muditbhargava66/open-crypto-hdl/src/aes_gcm_top.v

// ============================================================
//  aes_gcm_top.v — AES-256-GCM Logic Wrapper
//  NIST SP 800-38D
// ============================================================
/* verilator lint_off MULTITOP */
`default_nettype none
module aes_gcm_top (
    input  wire         clk,
    input  wire         rst_n,

    // Configuration
    /* verilator lint_off UNUSED */
    input  wire [255:0] key,
    /* verilator lint_on UNUSED */
    input  wire  [95:0] iv,
    input  wire  [63:0] aad_len,
    input  wire  [63:0] pt_len,
    input  wire         start,

    // AAD input
    input  wire [127:0] aad_block,
    input  wire         aad_valid,
    output wire         aad_ready,

    // Plaintext input
    input  wire [127:0] pt_block,
    input  wire         pt_valid,

    // Ciphertext output
    output reg  [127:0] ct_block,
    output reg          ct_valid,

    // Tag output
    output reg  [127:0] tag,
    output reg          tag_valid,

    // Status
    output reg          busy,

    // Shared AES Interface
    output reg  [127:0] aes_pt,
    output reg          aes_load,
    input  wire [127:0] aes_ct,
    input  wire         aes_done
);
    // ---- States ----
    localparam S_IDLE      = 4'd0;
    localparam S_HASHKEY   = 4'd1;
    localparam S_HASHKEY_W = 4'd2;
    localparam S_AAD       = 4'd3;
    localparam S_PT        = 4'd4;
    localparam S_LEN       = 4'd5;
    localparam S_TAG       = 4'd6;
    localparam S_TAG_W     = 4'd7;
    localparam S_DONE      = 4'd8;

    reg [3:0] state;
    reg [127:0] j0;
    reg  [31:0] ctr_val;

    // GHASH interface
    reg  [127:0] ghash_block;
    reg          ghash_init;
    reg          ghash_next;
    wire [127:0] ghash_result;
    wire         ghash_ready;

    reg  [127:0] H;
    reg   [95:0] iv_reg;

    ghash_core u_ghash (
        .clk    (clk),
        .rst_n  (rst_n),
        .h      (H),
        .block  (ghash_block),
        .init   (ghash_init),
        .next   (ghash_next),
        .result (ghash_result),
        .ready  (ghash_ready)
    );

    reg [127:0] keystream_buf;
    reg         ks_valid;
    reg         aad_gh_running;
    reg [63:0] aad_processed;
    reg [63:0] pt_processed;

    assign aad_ready = (state == S_AAD) && !aad_gh_running;

    function [127:0] mask_block;
        input [127:0] data;
        input [63:0] processed;
        input [63:0] total;
        reg [3:0] diff;
        begin
            if (processed + 16 <= total) begin
                mask_block = data;
            end else begin
                diff = total[3:0] - processed[3:0];
                case (diff)
                    4'd1:  mask_block = data & 128'hFF000000000000000000000000000000;
                    4'd2:  mask_block = data & 128'hFFFF0000000000000000000000000000;
                    4'd3:  mask_block = data & 128'hFFFFFF00000000000000000000000000;
                    4'd4:  mask_block = data & 128'hFFFFFFFF000000000000000000000000;
                    4'd5:  mask_block = data & 128'hFFFFFFFFFF0000000000000000000000;
                    4'd6:  mask_block = data & 128'hFFFFFFFFFFFF00000000000000000000;
                    4'd7:  mask_block = data & 128'hFFFFFFFFFFFFFF000000000000000000;
                    4'd8:  mask_block = data & 128'hFFFFFFFFFFFFFFFF0000000000000000;
                    4'd9:  mask_block = data & 128'hFFFFFFFFFFFFFFFFFF00000000000000;
                    4'd10: mask_block = data & 128'hFFFFFFFFFFFFFFFFFFFF000000000000;
                    4'd11: mask_block = data & 128'hFFFFFFFFFFFFFFFFFFFFFF0000000000;
                    4'd12: mask_block = data & 128'hFFFFFFFFFFFFFFFFFFFFFFFF00000000;
                    4'd13: mask_block = data & 128'hFFFFFFFFFFFFFFFFFFFFFFFFFF000000;
                    4'd14: mask_block = data & 128'hFFFFFFFFFFFFFFFFFFFFFFFFFFFF0000;
                    4'd15: mask_block = data & 128'hFFFFFFFFFFFFFFFFFFFFFFFFFFFFFF00;
                    default: mask_block = 128'd0;
                endcase
            end
        end
    endfunction

    always @(posedge clk or negedge rst_n) begin
        if (!rst_n) begin
            state     <= S_IDLE;
            busy      <= 1'b0;
            ct_valid  <= 1'b0;
            tag_valid <= 1'b0;
            aes_load  <= 1'b0;
            ghash_init <= 1'b0;
            ghash_next <= 1'b0;
            ctr_val   <= 32'd0;
            aad_processed <= 64'd0;
            pt_processed  <= 64'd0;
        end else begin
            aes_load   <= 1'b0;
            ghash_init <= 1'b0;
            ghash_next <= 1'b0;
            ct_valid   <= 1'b0;
            tag_valid  <= 1'b0;

            case (state)
                S_IDLE: begin
                    if (start) begin
                        iv_reg    <= iv;
                        j0        <= {iv, 32'h00000001};
                        ctr_val   <= 32'd2;
                        aes_pt    <= 128'd0;
                        aes_load  <= 1'b1;
                        busy      <= 1'b1;
                        aad_processed <= 64'd0;
                        pt_processed  <= 64'd0;
                        state     <= S_HASHKEY_W;
                    end
                end

                S_HASHKEY_W: begin
                    if (aes_done) begin
                        H <= aes_ct;
                        ghash_init <= 1'b1;
                        if (aad_len == 64'd0) begin
                            state <= S_PT;
                            ks_valid <= 1'b0;
                            if (pt_len > 0) begin
                                aes_pt   <= {iv_reg, 32'd2};
                                aes_load <= 1'b1;
                                ctr_val  <= 32'd3;
                            end
                        end else begin
                            state <= S_AAD;
                        end
                        aad_gh_running <= 1'b0;
                    end
                end

                S_AAD: begin
                    if (aad_valid && !aad_gh_running) begin
                        ghash_block    <= mask_block(aad_block, aad_processed, aad_len);
                        ghash_next     <= 1'b1;
                        aad_gh_running <= 1'b1;
                        aad_processed  <= aad_processed + 64'd16;
                    end
                    if (ghash_ready) begin
                        aad_gh_running <= 1'b0;
                        if (aad_processed >= aad_len) begin
                            state <= S_PT;
                            ks_valid <= 1'b0;
                            if (pt_len > 0) begin
                                aes_pt   <= {iv_reg, 32'd2};
                                aes_load <= 1'b1;
                                ctr_val  <= 32'd3;
                            end
                        end
                    end
                end

                S_PT: begin
                    if (pt_len == 0) begin
                        state <= S_LEN;
                    end else begin
                        if (aes_done && !ks_valid) begin
                            keystream_buf <= aes_ct;
                            ks_valid      <= 1'b1;
                        end
                        if (pt_valid && ks_valid && !ghash_next) begin
                            ct_block <= mask_block(pt_block ^ keystream_buf, pt_processed, pt_len);
                            ct_valid <= 1'b1;
                            ks_valid <= 1'b0;
                            ghash_block <= mask_block(pt_block ^ keystream_buf, pt_processed, pt_len);
                            ghash_next  <= 1'b1;
                            pt_processed <= pt_processed + 64'd16;
                            if (pt_processed + 64'd16 < pt_len) begin
                                aes_pt   <= {iv_reg, ctr_val};
                                aes_load <= 1'b1;
                                ctr_val  <= ctr_val + 32'd1;
                            end
                        end
                        if (ghash_ready && pt_processed >= pt_len) state <= S_LEN;
                    end
                end

                S_LEN: begin
                    ghash_block <= {aad_len << 3, pt_len << 3};
                    ghash_next  <= 1'b1;
                    state       <= S_TAG_W;
                end

                S_TAG_W: begin
                    if (ghash_ready) begin
                        aes_pt   <= j0;
                        aes_load <= 1'b1;
                        state    <= S_TAG;
                    end
                end

                S_TAG: begin
                    if (aes_done) begin
                        tag       <= aes_ct ^ ghash_result;
                        tag_valid <= 1'b1;
                        busy      <= 1'b0;
                        state     <= S_IDLE;
                    end
                end
                default: state <= S_IDLE;
            endcase
        end
    end
endmodule
