muditbhargava66/open-crypto-hdl/(commit log)

2026-04-14 feat: add complete RTL source tree for all cipher cores
    Add synthesizable Verilog 2001 RTL for:
    - ChaCha20 stream cipher (RFC 8439): quarter-round + 20-round core
    - Poly1305 MAC (RFC 8439): 130-bit GF multiply-accumulate
    - ChaCha20-Poly1305 AEAD integration (RFC 8439)
    - AES-256 (FIPS 197): S-Box + iterative 14-round core + CTR mode
    - GF(2^128) multiplier + GHASH (NIST SP 800-38D)
    - AES-256-GCM AEAD integration (NIST SP 800-38D)
    - DES (FIPS 46-3): 16-round Feistel + 3DES wrapper
    - TinyTapeout SPI-control wrapper (tt_um_crypto_top)
    All modules use default_nettype none/wire guards and include
    standard reference citations in module headers.
2026-04-14 test: add cocotb and SystemVerilog testbenches for all cores
    cocotb testbenches (tb/cocotb/):
    - test_chacha20.py: RFC 8439 A.1 vector, consecutive blocks, zero key
    - test_des.py: NIST KAT encrypt vectors, decrypt roundtrip
    - test_aes.py: FIPS 197 C.3, AESAVS GFSbox, back-to-back, S-Box, all-ones
    - test_gf128_mul.py: zero-multiply, commutativity, known vectors, determinism
    - test_ghash.py: zero-block, non-zero, two-block streaming, re-init
    - test_poly1305.py: RFC 8439 2.5.2 vector, single-block, zero-message
    - test_aes_ctr.py: NIST SP 800-38A F.5.5, counter increment, start reset
    - test_aes_gcm.py: startup flow, single-block encrypt, zero-key smoke test
    - test_chacha20poly1305.py: OTK generat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
    [reference_model.py, spi_driver.py, tb_chacha20.sv, tb_des.sv, tb_tdes.sv]
2026-04-14 fix(constraints): rewrite Arty A7 XDC to resolve duplicate pin assignments
    The previous XDC had multiple pins assigned to more than one signal:
    - A8 was triple-assigned to ena, ui_in[0], and ui_in[7]
    - K16 and J16 were double-assigned to uio_in and uo_out
    - A11 was double-assigned to uio_out[0] and uio_out[1]
    - uio_in[0] was constrained twice at lines 31 and 74
    These conflicts cause Vivado DRC errors during implementation.
    New pin mapping strategy:
    - clk: E3 (on-board 100 MHz oscillator)
    - rst_n: BTN0 (D9)
    - ena: SW0 (A8, sole assignment)
    - uio[7:0] SPI: Pmod JA (G13, B11, A11, D12, D13, B18, A18, K16)
    - ui_in[7:0]: Pmod JB (E15, E16, D15, C15, J17, J18, K15, J15)
    - uo_out[7:0]: LEDs LD0-L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
    [arty_a7.xdc]
2026-04-14 fix(fusesoc): remove self-referencing dependency and clean up core file
    Fix three issues in the FuseSoC package descriptor:
    1. The chacha20 tb_sv fileset contained a depend entry referencing
    open-crypto-hdl:chacha20:0.1.0, creating a circular dependency
    that caused FuseSoC to fail during resolution.
    2. The aes256 core definition had an orphaned fileset named 'depend'
    containing a core reference string. This was never referenced by
    any target and was likely a copy-paste error.
    3. Added tb_cocotb fileset to the aes256 core definition pointing
    to the cocotb test file.
    All six core definitions (chacha20, des, aes256, aes-gcm,
    chacha20poly1305, tt-top) now have clean filesets a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
2026-04-14 fix(ci): resolve four workflow failures in GitHub Actions
    1. cocotb shell expansion: The YAML run blocks used unquoted
    $(cocotb-config ...) which was not being evaluated as command
    substitution. Fixed by wrapping in double quotes inside a
    multi-line shell block using export + make.
    2. sv2v-check job: The lint step called verilator but the job
    never installed it. Added apt-get install verilator.
    3. formal job: Used 'pip install symbiyosys' which is not a valid
    pip package. Replaced with YosysHQ/setup-oss-cad-suite@v3
    GitHub Action, which provides yosys, sby, and SMT solvers.
    4. Missing AES simulation: Added a cocotb-aes step to the
    simulate-cocotb job. Added sim_build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
2026-04-14 docs: update README, Makefile, and docs to reflect current test coverage
    Makefile:
    - Add six new cocotb targets: cocotb-gf128, cocotb-ghash,
    cocotb-poly1305, cocotb-aes-ctr, cocotb-aes-gcm,
    cocotb-chacha20poly1305
    - Add cocotb-all aggregate target
    - Include synth-tdes in synth-all
    - Update help text with all available targets
    README.md:
    - Fix formal verification install instructions (SymbiYosys is not
    a pip package, point to oss-cad-suite instead)
    - Add all new cocotb simulation targets to Quick Start
    - Update Test Coverage table: 30 cocotb tests across 9 files
    - Add constraints/ to project structure tree
    CONTRIBUTING.md:
    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
2026-04-16 Optimize crypto cores for area and fix SPI read-back path
    - Refactored AES, ChaCha20, and Poly1305 to iterative architectures for TinyTapeout.
    - Total cell count reduced from 98k to 4.6k, well within 2x2 tile limits.
    - Implemented full SPI MISO read-back for status and result registers.
    - Fixed endianness and timeout issues in cocotb test suite.
    - Cleaned up all linter warnings in RTL.
    [aes_core.v, aes_gcm_top.v, aes_sbox.v, chacha20_core.v, des_core.v, poly1305_core.v, tdes_core.v]
2026-04-16 Fix Poly1305 RFC test mismatch and refine area optimization
    - Corrected endianness in Poly1305 core to match RFC 8439 (little-endian bytes).
    - Implemented strict modular reduction in bit-serial Poly1305.
    - Fixed partial block hibit placement.
    - All cocotb Poly1305 tests now PASS.
    [poly1305_core.v]
2026-04-16 Finalize area-optimized Silicon design and technical documentation
    - Refactored AES, ChaCha20, and Poly1305 for iterative area efficiency (98k to 4.7k cells).
    - Integrated all cores into TinyTapeout SPI wrapper with full read-back.
    - Updated documentation (ASIC_IMPLEMENTATION.md, synthesis_report.md) with Silicon metrics.
    - Fixed GitHub Actions CI pipeline by using Makefile targets and resolving lint warnings.
    - Cleaned up DES and Poly1305 RTL to ensure 100% lint compliance.
    - Configured .gitignore for local report exclusion and removed area_report.txt from index.
    [aes_gcm_top.v, des_core.v, poly1305_core.v, tt_um_crypto_top.v]
2026-04-16 feat: silicon-optimized cryptographic suite for TinyTapeout
    Refactored AES-256, ChaCha20, and Poly1305 into area-optimized iterative
    architectures, reducing cell count to 4,666. Achieved timing closure at
    20-40 MHz across all 9 PVT corners. Formally verified AES and ChaCha20 safety
    properties via SymbiYosys. Updated documentation with STA reports and SPI
    register map.
2026-04-16 feat: unified AEAD suite with core-sharing and CDC synchronizers
    - Consolidated all nested RTL into the flat src/ directory for TinyTapeout compatibility.
    - Integrated AES-GCM and ChaCha20-Poly1305 AEAD logic wrappers into the top-level.
    - Refactored architecture to share AES-256, ChaCha20, and Poly1305 cores between raw and AEAD modes.
    - Added 2-stage CDC synchronizers for SPI clock, data, and chip-select inputs.
    - Expanded SPI register map to include AAD/PT length registers and DES direction control.
    - Updated SPI driver with high-level AEAD methods and full register definitions.
    - Fixed width mismatches and lint warnings across all modules.
    [aes_core.v, aes_core_formal.v, aes_gcm_top.v, chacha20_core.v, chacha20_core_formal.v, chacha20poly1305_top.v, des_formal_inv.v]
2026-04-17 chore: final v1.1.0 documentation and layout updates
    - Updated layout.png and layout.svg with the new AEAD-integrated suite.
    - Added CHANGELOG.md documenting v1.0.0 and v1.1.0 releases.
    - Synchronized OpenLane, FuseSoC, and Quartus configurations with v1.1.0 sources.
    - Overhauled documentation (README, PINOUT) for full AEAD feature set.
